Pajaaaa/Mhpower-UPS/docs/foto-realizace/03-detail-esp-zapojeni-jiny-uhel.jpg

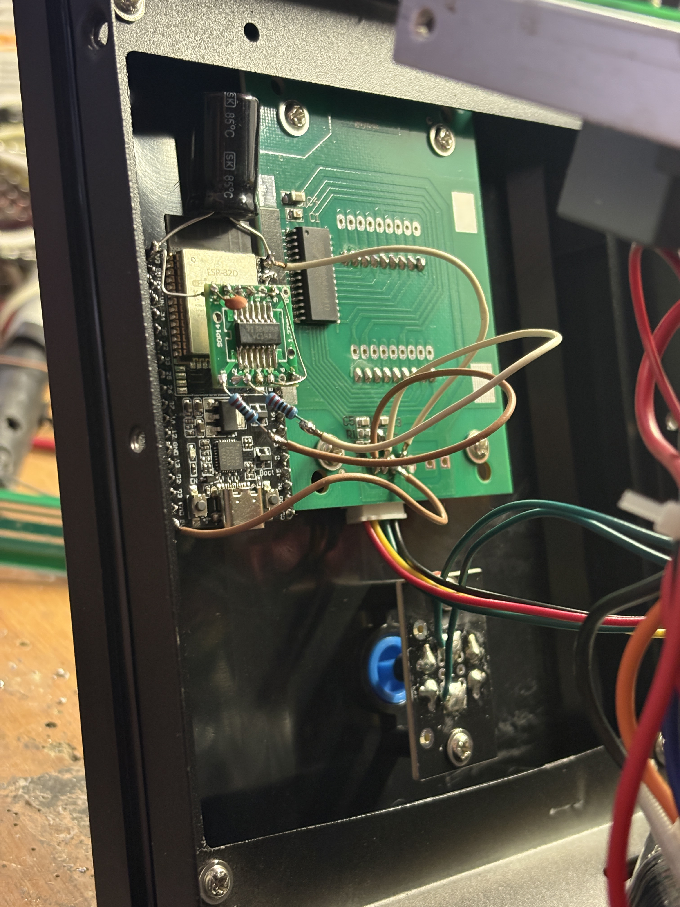
docs/foto-realizace/03-detail-esp-zapojeni-jiny-uhel.jpg
