Pajaaaa/Mhpower-UPS/docs/foto-realizace/04-esp-namontovany-ve-skrini.jpg

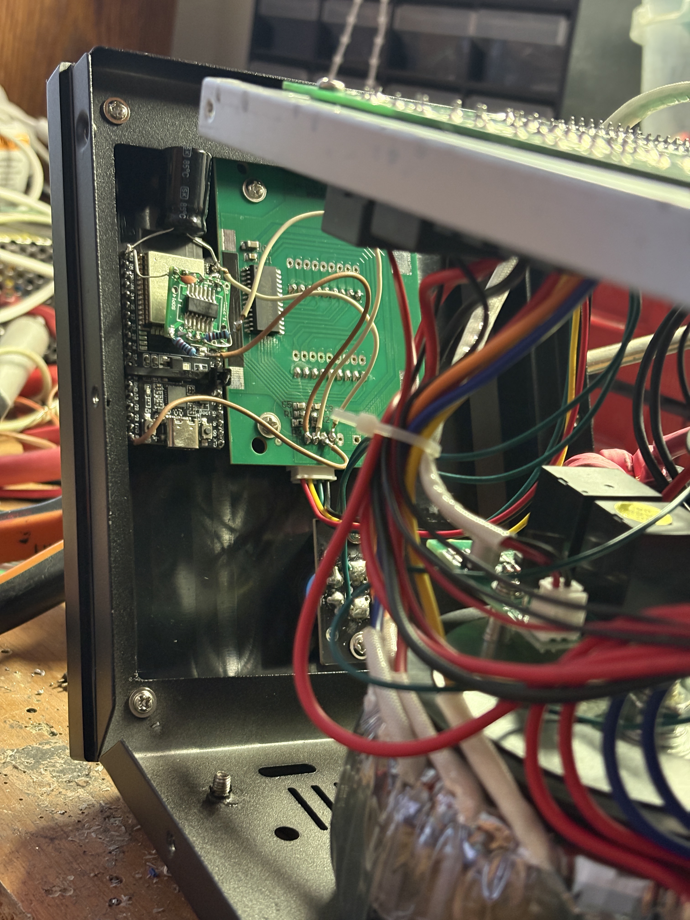
docs/foto-realizace/04-esp-namontovany-ve-skrini.jpg
