Pajaaaa/Mhpower-UPS/docs/zapojeni_chip.png

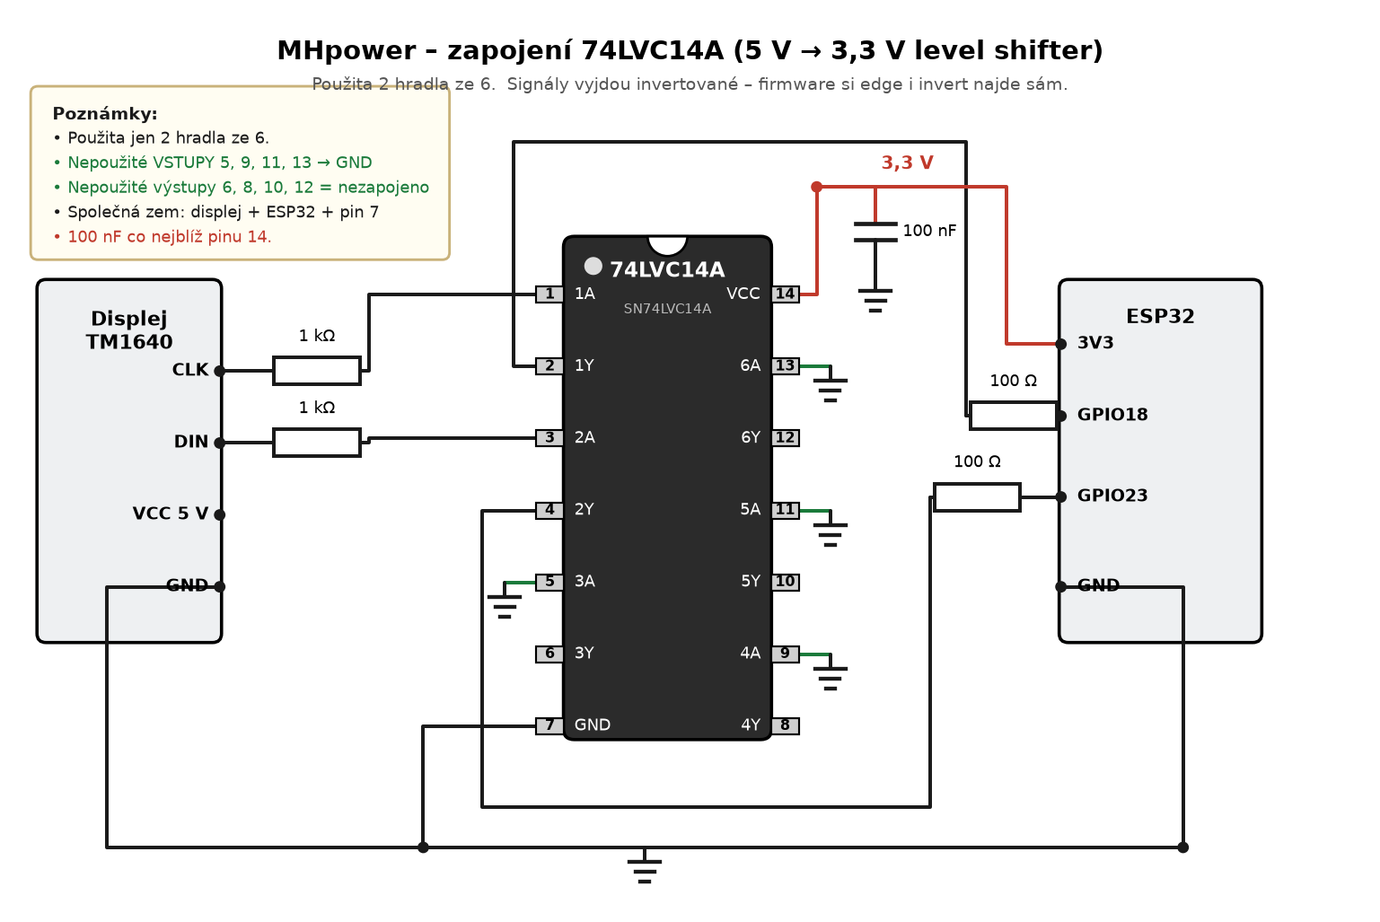
docs/zapojeni_chip.png
