Pajaaaa/Mhpower-UPS/docs/zapojeni_spravne.png

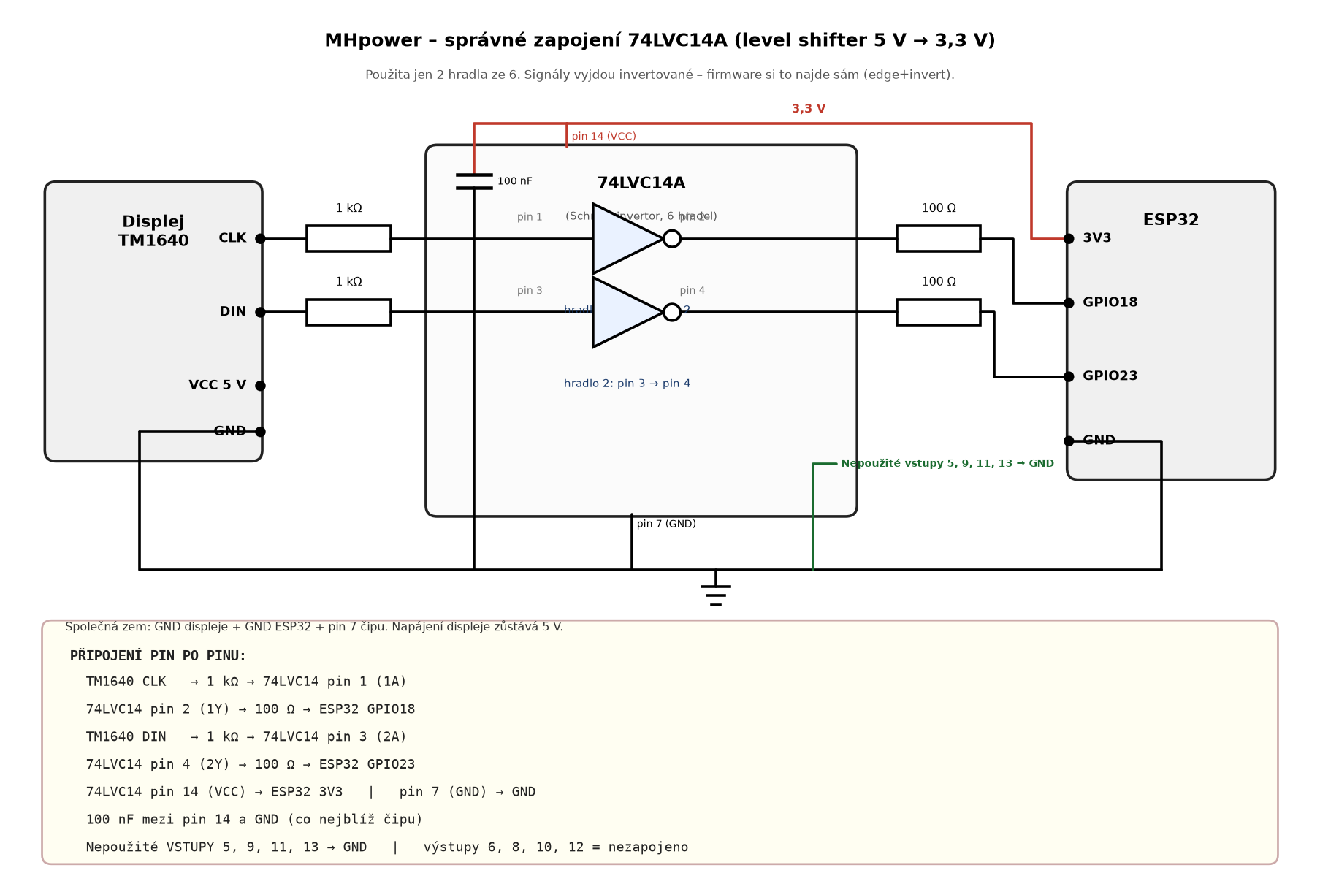
docs/zapojeni_spravne.png
