Pajaaaa/Mhpower-UPS/(commit log)

2026-06-16 Initial commit: MHpower UPS monitor (ESP32, TM1640 sniffer)
    - firmware mhpower_esp32_capture: webový dashboard, SNMP v1, OTA s progress barem,
    odhad výdrže baterie (Peukert prior + učení Wh na dílek), diagnostika výpadků,
    úsporný režim (snížený WiFi TX, modem-sleep, CPU 160 MHz, BT off)
    - mhpower_diag: sériový diagnostický skeč sběrnice TM1640
    - legacy/mhpower_wemos: starší ESP8266 varianta
    - docs: schémata zapojení; tools: dekodéry sigrok záznamů + generátory schémat
    - ukázkové záznamy sběrnice (.sr) a kompletní README
2026-06-16 docs: zapojení přes 74LVC14A (Schmittův invertor), ne dělič
    Skutečné HW zapojení používá Schmittův invertor 74LVC14A (level-shift 5V->3V3
    + čištění hran hysterezí), jak ukazují schémata v docs/. Oprava README i
    hlavičkového komentáře firmwaru, které dříve mylně mluvily o děliči napětí.
2026-06-16 firmware: stabilita, úspora, mDNS, log událostí, SNMP rozšíření, úklid
    A) WiFi dohled (onEvent + aktivní reconnect, po 5 min bez WiFi restart) + task watchdog (15 s)
    B) throttle snímání (CAPTURE_INTERVAL_MS) + CAPTURE_SAMPLES 18000->10000 (méně RAM, kratší okno bez IRQ)
    C) mDNS (<název>.local), nové diagnostiky do SNMP (OID 39-44: uptime/heap/reset/TX/CPU),
    kruhový log událostí + NTP + /api/events + panel "Poslední události" na monitoru
    D) smazán mrtvý kód (feedByte/parser/bitCount/byteShift/lastClk); hesla se už nevykreslují
    do formuláře nastavení (placeholder "beze změny", prázdné = neměnit)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
    [mhpower_esp32_capture.ino]
2026-06-16 feat: podlimitní kondice/výdrž se zapíše do logu událostí
    detectEvents() nově loguje náběh healthWarning ("Kondice baterie pod prahem")
    a runtimeWarning ("Výdrž pod limitem") – objeví se v Poslední události i /api/events.
2026-06-16 fix: CAPTURE_SAMPLES zpět na 18000 (10000 ořezávalo rámec -> err ~25 %)
    Při 160 MHz pokryje 10000 vzorků jen ~160 µs, ale rámec TM1640 trvá ~192 µs,
    takže se část snímků ořízla a nedekódovala. 18000 dá ~290 µs rezervu.
    [mhpower_esp32_capture.ino]
2026-06-16 firmware: odstraněn mDNS (zmenšení binárky kvůli OTA)
    ESPmDNS responder pryč; zůstává jen WiFi.setHostname() (DHCP název, zdarma
    z WiFi knihovny). Šetří desítky KB, aby se app vešla do OTA slotu.
2026-06-17 firmware: mDNS zpět + záchranný AP hotspot při nepřipojené WiFi
    - ESPmDNS responder obnoven (http://<název>.local).
    - Záchranný hotspot (AP_STA): SSID MHpower-<MAC>, WPA2 heslo mhpower-setup,
    web na 192.168.4.1. Nahodí se, když se STA nepřipojí (do 15 s po startu
    nebo po 5 min výpadku); reconnect běží na pozadí, po obnově WiFi se hotspot
    sám vypne (kvůli odběru/brownoutu).
    - Nahrazen nekonečný 5min restart (špatně zadanou WiFi neopravil) -> hotspot.
    Task watchdog jako HW pojistka zůstává.
    - README: vrácen mDNS bod, upraven popis WiFi dohledu.
    [mhpower_esp32_capture.ino]
2026-06-17 firmware: bezpečnost OTA + opravy (auth, XSS, WDT, mDNS, baterie, pojistka)
    1. OTA upload (/update) ověřuje heslo už v UPLOAD_FILE_START + Update.abort()
    při neúspěchu/chybě zápisu -> nelze nahrát firmware bez přihlášení.
    2. escHtml escapuje i apostrof (&#39;) -> apostrof v SSID/názvu nerozbije
    formulář a zacpává uložené XSS na stránce systém.
    3. Task watchdog se krmí během OTA zápisu -> pomalý upload nezpůsobí reset.
    4. mDNS se přehlašuje při každém (re)connectu (startMdns na STA_GOT_IP).
    5. Nízká baterie je teď samostatný stav (<=1 dílek), který kritická zahrnuje
    -> "Nízká baterie" přijde dřív než "Kritická".
    6. Poslední pojistka: 1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
    [mhpower_esp32_capture.ino]
2026-06-17 firmware: oprava falešného "nabíjení" z glitche dekódu ikony baterie
    Jeden chybně dekódovaný snímek (err ~34 %) strčil odlišnou hodnotu mem[9]
    do historie a batteryPatternIsChanging() to hlásil jako animaci nabíjení
    (stačil jediný odlišný vzorek) -> bliklo "nabíjení" a vrátilo se.
    - rememberBatteryPattern: do historie jen platné ikony (neplatný bajt zahodit)
    - batteryPatternIsChanging: "mění se" jen když se od nejčastější hodnoty liší
    aspoň 2 vzorky (jeden odskok = glitch, ne animace)
    [mhpower_esp32_capture.ino]
2026-06-17 firmware: verze v1.4 (footer) – odpovídá počtu úprav této session
    v1.0 -> v1.4: ① mDNS+hotspot ② info o hotspotu ③ OTA bezpečnost + opravy
    ④ falešné "nabíjení". Zobrazuje se v patičce dashboardu i stránky systém.
2026-06-17 firmware: pojistka proti zaseknutému web serveru + v1.5
    Pozorováno na zařízení: stará verze měla zatuhlý HTTP server (loop, SNMP
    i ping běžely, jen TCP/80 timeoutoval); spravil to až reboot/reflash.
    - maintainWeb(): když 10 min nedorazí žádný HTTP požadavek, recykluje listen
    socket (server.stop()+begin()). Otevřený dashboard pollne á 3 s -> server
    je prokazatelně živý a nerecykluje se; je to recyklace socketu, ne reboot
    (zachová uptime/SNMP/naučená data). Hlídá se, aby to nevlezlo do OTA.
    - requireAuth() značkuje čas posledního požadavku (liveness).
    - verze v1.5 v patičce.
    [mhpower_esp32_capture.ino]
2026-06-17 firmware: OTA přežije odmítnutý/vadný upload (WDT fix) + v1.6
    handleUpdateUpload() krmil task WDT až za `if(!updateAuthorized) return;`
    ve WRITE větvi. Při zamítnutém zápisu (špatné heslo, Update.begin/write
    selže – např. nahraný 4MB merged obraz místo app .ino.bin) prohlížeč
    dotáhl zbytek souboru, loop task visel v server.handleClient() bez krmení
    WDT a po WDT_TIMEOUT_S přišel task-watchdog reboot (projevovalo se pádem
    kolem ~64 % uploadu). WDT reset přesunut na začátek callbacku → krmí se
    na každý chunk, odmítnutý upload v klidu doteče a vrátí čistou chybu.
    [mhpower_esp32_capture.ino]
2026-06-17 docs: historie vývoje (docs/HISTORIE.md) + odkaz z README
    Sepsáno z exportu vývojových konverzací (3.–17. 6. 2026) a git logu:
    reverse engineering TM1640, HW iterace Wemos→ATmega2560→ESP32, boj se
    čtením sběrnice na ESP32, odrušení Schmittovým invertorem a přehled
    milníků v1.0–v1.6. Bez reálných hesel (jen placeholdery).
2026-06-17 HW identifikátor desky (MAC) na web + SNMP idx 45 + v1.7
    Každá deska má teď trvalý otisk = MAC z eFuse (AA:BB:CC:DD:EE:FF),
    který přežije reflash i smazání NVS – slouží k odlišení více kusů
    v jednom racku.
    - deviceHwId() z WiFi.macAddress()
    - /api/status: nové pole "hwId"
    - web hlavička: "ID <MAC>" v podtitulku
    - /settings: poznámka s HW ID (SNMP idx 45)
    - SNMP: nový idx 45 (string), SNMP_MAX_INDEX 44->45
    - README: OID tabulka rozšířena o idx 45
    - footer v1.6 -> v1.7
2026-06-18 firmware: debounce alarm/přetížení proti glitchům jednoho rámce + v1.8
    Stavové příznaky alarm (mem[6] & 0x04) a přetížení (mem[7]==0x7F) se braly
    syrově z jednoho rámce. Jeden zkažený rámec (běžné u pasivního odposlechu,
    errors v řádu tisíců) tak dělal falešný alarm/přetížení -> v power monitoru
    to vyskočilo jako "summary_error" a hned "summary_ok" (1 poll, ~30 s).
    onBattery na stejném bytu glitch ustojí díky SOURCE_CONFIRM_FRAMES, proto v
    noci nebyl ani jeden falešný mains_lost, ale summary_error blikal. Nová
    confirmFlag() dává alarmu i přetížení stejný potvrzovací debounce (3 rámce).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
    [mhpower_esp32_capture.ino]
2026-06-18 firmware: odchyt neznámých číslic displeje (/api/digitscan) + v1.9
    Pasivní dekód displeje nezná segmentový vzor číslice 9 (digitFromPattern), takže
    napětí s devítkou (např. 229 V) spadne na -1 a celý rámec se ve filtru zahodí dřív,
    než bychom syrový bajt viděli. Nový záchyt v updateDecodedState BĚŽÍ PŘED filtrem
    napětí: projede obě trojice číslic a neznámou zapíše jen když obě sousední v téže
    trojici jsou platné 0–9 (silný signál reálného glyfu, ne šum z odposlechu).
    Histogram + poslední kontext se čtou přes nový endpoint /api/digitscan (text/plain).
    guessDigitFromSegments z bit-layoutu predikuje 9 = 0x7D (s tečkou 0xFD). Po potvrzení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
2026-06-19 firmware: přepětí/podpětí (AVR V↑/V↓) + icon-scan + 24V/48V baterie + v1.11
    - overVoltage/underVoltage z dekódovaného vstupu (prahy 253/207 V), pole avrState
    - /api/iconscan: histogram mem[6]/mem[8] s kontextem napětí (hon na reálné bity V↑/V↓/⚠️)
    - batterySystemVoltage 12/24/48 V (web + NVS) -> škálování odhadu napětí i Wh kapacity
    - nové SNMP idx 46 přepětí, 47 podpětí, 48 avrState; web dlaždice Síť (AVR) + pills
    - frekvence zámerně ponechána natvrdo 50 Hz (v HK se nemení)
2026-06-19 docs: changelog v1.11 (přepětí/podpětí + icon-scan + 24V/48V baterie)
2026-06-19 firmware: všechny modely MPU v dropdownu + napětí baterie auto z modelu
    - Typ zdroje: všech 14 modelů 300-5000W (z manuálu) místo 4
    - napětí baterie (12/24/48V) se odvodí z modelu (batteryVoltageForWatts:
    ≤800W=12V, ≤2500W=24V, jinak 48V; potvrzeno tabulkou výdrže v manuálu)
    - zrušen ruční select napětí baterie (i NVS batSysV / form batV)
    - dropdown ukazuje u modelu i odvozené napětí (např. 'MHpower 3000W (48V baterie)')
2026-06-19 docs: changelog — všechny modely MPU + auto napětí baterie
2026-06-21 firmware: proaktivní odhad výdrže baterie i na síti + v1.12
    Nové pole state.runtimeProjectedSec — odhad "kdyby teď vypadl proud, jak dlouho
    baterie při aktuální zátěži vydrží". Na baterii = runtimeRemainingEstimateSec,
    na síti se počítá z loadWattsEstimate a stavu baterie (estimateRuntimeFromBars
    nebo Peukert prior usableBatteryWhAtDrain), s ošetřením plné baterie
    (batteryFull || bars>=5 -> celková energie místo mid-bar odhadu); bez zátěže -1.
    Vystaveno: JSON /api/status (runtimeProjectedSec), web dashboard (na síti dlaždice
    "Běh na baterii" ukáže ~odhad výdrže při výpadku se zátěží), SNMP idx 49.
    Bump v1.11 -> v1.12 (footery + hlavičky scan endpoi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
2026-06-21 firmware: odhad výdrže i při nulové zátěži + v1.13
    Když displej hlásí 0 zátěž a výstup je zapnutý, odhad výdrže (na síti i na baterii)
    počítá s minimální zátěží 10 % jmenovitého výkonu (assumedDrainWattsForEstimate) —
    orientační horní odhad, místo prázdného "-". Účtování energie a učení Wh/dílek
    zůstává na reálném batteryDrainWatts (nuluje se při 0 zátěži, žádné falešné učení).
    Web rozliší reálnou zátěž vs "orientačně, min. zátěž". Bump v1.12 -> v1.13.
2026-06-23 firmware: guest read-only přihlášení + Wi-Fi sekce s upozorněním na restart + v1.15
    - napevno účet guest/guest (jen čtení): vidí dashboard, /api/status a
    /api/events, ale nesmí nic měnit. Nastavení, restart, OTA i dev-scany
    (digit/icon) zůstávají jen adminovi (webUser/webPass).
    - web rozlišuje úroveň přístupu: webAuthLevel() → AUTH_NONE/GUEST/ADMIN,
    requireRead() pustí guesta i admina, requireAuth() jen admina.
    - dashboard: pro hosta se skryje odkaz „systém" a ukáže odznak „jen čtení";
    /api/status nese pole "isAdmin".
    - nastavení: Wi-Fi (SSID + heslo) vyčleněno do samostatné sekce s výrazným
    upozorněním, že se změna projeví až po restar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
2026-06-23 firmware: odkaz na API v adminu (sekce Rozhraní) + SNMP info
    Stránka systém má novou sekci „Rozhraní (API)" s odkazy na /api/status,
    /api/events, /api/digitscan, /api/iconscan a shrnutím SNMP (UDP/161, OID).
2026-06-23 docs: fotky skutečného provedení (zástavba ESP + instalace v provozu)
    8 fotek roztříděno do docs/foto-realizace/ s popisným pojmenováním a indexem
    (README.md): detail ESP32 na desce displeje s TM1640 a 74LVC14A level-shifterem,
    montáž do skříně, sestavený kus s rozsvíceným displejem i reálná instalace
    v rozvaděči (baterie GE100-12, MikroTik mAP brána). Odkaz z hlavního README.
2026-06-23 firmware: tlačítko „odhlásit" pro přepnutí uživatele + v1.16
    Nový endpoint /logout (vždy 401). Odkaz „odhlásit" v hlavičce monitoru i na
    stránce systém pošle XHR s neplatnými údaji logout/logout → prohlížeč zahodí
    uložené HTTP Basic-auth přihlášení a při dalším požadavku znovu vyzve, takže
    se lze přepnout mezi účtem admin a guest.
2026-06-23 docs: úvodní stránka kompletní — hero foto, náhledy provedení a doplněné funkce/SNMP
    - nahoře hero foto hotové zástavby (zmenšený náhled), v Hardware sekci dva náhledy
    (detail ESP+TM1640+74LVC14A, instalace v rozvaděči s MikroTik mAP)
    - Funkce doplněny: dvě úrovně přístupu (admin/guest) + odhlásit, přepětí/podpětí
    (V↑/V↓, AVR), 24/48V baterie a 14 modelů MPU, proaktivní odhad výdrže i na síti
    - SNMP rozšířeno o idx 46–49 (přepětí/podpětí/AVR/proaktivní výdrž), počet OID 45→49
    - historie verzí v1.0–v1.16
    - náhledy (hero-/thumb-*.jpg) zmenšené Pillow z fotek v galerii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
2026-06-23 docs: jazyková a typografická korektura (uvozovky, gramatika, konzistence)
    - sjednoceny české uvozovky „…“ (zavírací z rovných " → “) napříč README i HISTORIE
    - README: oprava „MHpowru" → „MHpoweru", plynulejší úvodní věta (em dash místo
    dvojitého „a"), „default" → „výchozí", sjednoceno „Wi‑Fi" → „WiFi"
    - HISTORIE: rozsah milníků z gitu 16.–17. 6. → 16.–23. 6.
2026-06-25 fix(snmp): zpřístupnit OID .49 (odhad výdrže) — SNMP_MAX_INDEX 48 → 49
    runtimeProjectedSec (proaktivní odhad výdrže i na síti) je v getSnmpValue
    namapovaný na idx 49 už od v1.12, ale SNMP_MAX_INDEX zůstal 48, takže
    agent GET/GETNEXT na .49 ignoroval (bez odpovědi). Power monitor proto
    viděl jen .27 (na síti -1) a ukazoval „-". Bump na 49 OID zpřístupní.
    Verze v1.16 → v1.17.
    [mhpower_esp32_capture.ino]
2026-07-01 fix(wifi): odolnost po výpadku brány (mAP) — reconnect, hotspot, watchdog
    Reakce na incident na zdroji Divišova: mAP vyplnut/zaplnut → ESP se
    nepřipojilo, nenaskočil ani záchranný hotspot, nutný fyzický restart
    (watchdog nezabral, protože loop task se dál krmil).
    - bindSnmpUdp/startMdns ven z WiFi event callbacku: GOT_IP jen nastaví
    flag, síťovou inicializaci dodělá maintainWifi() z loop tasku
    (lwIP/mDNS v event kontextu hrozí deadlockem — přesně cesta reconnectu).
    - startApFallback ověřuje návratovku WiFi.softAP(): při selhání nenastaví
    apFallbackActive → hotspot se zkusí znovu (dřív se „odškrtl" a už nikdy
    nenaskočil); throttle opakovanýc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
    [mhpower_esp32_capture.ino]
2026-07-01 feat(wifi): nastavitelný vysílací výkon Wi-Fi ve webu (v1.19)
    Dřív natvrdo WIFI_POWER_5dBm. Nově položka settings.wifiTxQdbm
    (¼ dBm, NVS klíč "wifiTx", výchozí 20 = 5 dBm), tabulka povolených
    hodnot WIFI_TX_OPTS (2–19,5 dBm) + isValidTxQdbm/currentTxPower.
    - <select> ve Wi-Fi sekci nastavení; validace na povolené hodnoty.
    - výkon se aplikuje IHNED bez restartu (WiFi.setTxPower v POST handleru)
    — na rozdíl od SSID/hesla; hlídané hodnoty přežijí reboot v NVS.
    - odstraněna konstanta WIFI_TX_POWER, 4 použití → currentTxPower().
    - verze v1.18 → v1.19; README + changelog (vč. narovnání časování
    hotspot 1 min / hard reboot 10 min v prose).
    Motivace: inc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
    [mhpower_esp32_capture.ino]
2026-07-02 firmware: revizni balik oprav a optimalizaci (audit) + v1.20
    - WDT krmeni behem boot cekani na WiFi (jinak boot-smycka bez WiFi, hotspot by nenaskocil)
    - ~16x rychlejsi neuspesny dekod: extractBits vytazen z order/phase smycek (tryDecodeFromBits),
    early-skip pri <96 bitech, krmeni WDT v prubehu plneho hledani
    - Peukert fallback napeti skalovan na 24V/48V banku (presnejsi runtimeProjectedSec na siti)
    - debounce prehrati (confirmFlag, 3 ramce) - stejna ochrana jako alarm/pretizeni od v1.8
    - dashboard neukaze 'full / -1.0 V' (JS test >0)
    - sanitizace batDate (uvozovka by rozbila JSON /api/status)
    - uptime z 64bit esp_timer_get_time() - nepretece po 49,7 dnech
    - zmena modelu s jinou bankou res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
    [mhpower_esp32_capture.ino]
2026-07-16 firmware: hloubková revize výpočtu výdrže + verze do SNMP + pojistka hesla (v1.21)
    Výdrž: debounce dílků baterie (3 rámce), stabilní SoC při nabíjecí
    animaci (min z okna historie), nečitelné dílky už se netváří jako plná
    baterie, Peukert se při učení kondice nezapočítává dvakrát, naučené
    Wh/dílek nesou i zátěž učení a predikce je koriguje na aktuální zátěž,
    avgDrainW s časovou konstantou ~45 s, energetický model počítá se
    středem pásma dílku zátěže.
    SNMP idx 50 = verze firmwaru (FW_VERSION jediné místo s verzí — web,
    /api/status, SNMP, dev-skeny); power monitor ji zobrazuje v detailu.
    Nastavení: login správce v samostatné sekci,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
2026-08-30 docs: přihláška — ocenění práce ownera v rozpočtu
    Claude-Session: https://claude.ai/code/session_01LQ2pQQNmGTJCkAgMMqjr4y
2026-08-30 docs: přihláška — práce ownera jen v člověkohodinách, bez ocenění
    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
2026-08-30 docs: přihláška — práce ownera bez poznámky o dobrovolnictví
    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
2026-08-30 docs: přihláška — kontaktní mail ownera
    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
2026-08-30 docs: přihláška — odstraněn řádek výjezdy na lokality z pracnosti
    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
2026-08-30 docs: přihláška — odstraněna poznámka o hrazení ze zdrojů řešitele
    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
2026-08-30 docs: přihláška — síť družstva, obecnější popis (dohled odlehlých lokalit), bez konkrétních lokalit, etapa 4 jako plánované testovací nasazení
    Claude-Session: https://claude.ai/code/session_01V2DZzZRnkB7p5Qv1pmSDuC
2026-09-03 fw v1.22: sanity kontrola rámce (rejected, SNMP idx 51), debounce přepětí/podpětí, icon/digit-scan uint32 + maxrun + reset
    Kontrola Čeperky 1 po 49 dnech: histogramy skenů přetekly (uint16, 12 slotů plných),
    posunuté rámce (mode 0x10 + výstup 235 V) procházely filtrem napětí, glitch 98 V
    zapínal underVoltage na 1 rámec. Neznámé číslice = známé ± 1 bit, žádný nový glyf.
    Claude-Session: https://claude.ai/code/session_01P2kRCrB7Gfy1bLfFBpmoaQ
    [mhpower_esp32_capture.ino]
